hengxufu/Programmable-DC-power-supply/(list of files, drawings)

Other design files:
ProPrj_主稳压电路_2025-12-27.epro
ProPrj_前板PCB制作_2025-12-27.epro
ProPrj_单片机制板_2025-12-27.epro
ProPrj_外设电路PCB板制作_2025-12-27.epro
