hengxufu/Programmable-DC-power-supply/(commit log)

2025-12-26 Add files via upload
    项目所用STM32F103C8T6单片机代码
2025-12-27 circuit schematics
2025-12-27 项目论文.md created from https://stackedit.cn/
